palcan/Custom-MFRC522-Board-Design/(threads)

Thread 1 (2024-12-25):

About custom mfrc board project.

Mali2702, 2024-12-25:
Hello,
I am a student of electric and electronic engineering. And ı really liked your project. I would want to make a familiar project. Could you tell me the dimensions you used when making the PCB layout?
thank you.
Mehmet Ali Kılıc

Mali2702, 2024-12-25:
And if you can say how you made the routing it would be perfect for me

palcan, 2025-01-07:
Yeah sure - I've added the Gerbers to the repo. Just use any gerber viewer you want to find the dimensions you need
